michalsemenisin/zaverecny_projekt/README.md

Cílem projektu je vytvořit robotické rameno, které využívá arduino
Rameno seskládané už mám - koupena "stavebnice" (jen kovová konstrukce)
Tento projekt používá 6 servomotorů, které byly součástí konstrukce, kterou jsem koupil z aliexpressu

Rameno se skládá z 6 servomotorů, které jsou napájeny z arduina - přesněji externího zdroje, protože samotné arduino neutáhne 6 servomotorů, může se ovládat pomocí potenciometrů a grafického uživatelského rozhraní vytvořeném v pythonu, později přidám funkci RECORD AND PLAY, tedy učení ramene
Ovládání serv po jednom je nudné a je to složité ovládat, takže posílám do Arduina kordinace (x,y,z) a měnit je je mnohem snažší
Samotný pohyb je složitý a je k tomu potřeba znalosti matematiky

<b>HARDWARE: </b> 
          <ul> <li> ARDUINO UNO </li> 
           <li> BREADBOARD </li> 
           <li> ARDUINO SENSOR SHIELD V5 </li> 
           <li> 6x SERVOMOTORY </li> 
           <li> STAVEBNICE RAMENE </li> 
           <li> JUMPING WIRES </li> 
           <li> SERVO EXTENDER KABELY </li> 
           <li> 6x POTENCIOMETR </li> 
           <li> EXTERNAL POWER SUPPLY </li> </ul>

            PLÁN
-----------------------------------------------------------------
1. NAKOUPENÍ SOUČÁSTEK - HOTOVO 
2. ZKOUMAT PROBLÉM A SOUČÁSTKY - HOTOVO
3. POSTAVENÍ KONSTRUKCE - HOTOVO
4. ZÁKLADNÍ POHYB - HOTOVO
5. VYLEPŠENÝ POHYB -
6. RECORD AND PLAY -
7.

- **ZDROJE:**
- https://www.hackster.io/dfilannino03/robotic-arm-plays-tic-tac-toe-7797b1 ----------- KALKULACE
- https://www.hackster.io/phpoc_man/arduino-control-arm-robot-via-web-379ef3 ---------- KALKULACE
- https://www.hackster.io/AhmedAzouz/pc-controlled-robotic-arm-841a41 ----------------- OVLADANI
- https://www.hackster.io/KureBasRobotics/gesture-controlled-trainable-arduino-robot-arm-via-bluetooth-4a1e57
